Kreyl/IR_PCB/Testing.txt

1) Quartz
2) Flash
3) Lumos

4) Audio
5) Neopix
6) IR TX/RX
7) Side LEDs
8) Front LEDs
9) GPIO
10) Buzzer

FULL FW

11) USB + power
