Kreyl/IR_PCB/IR_PCB_hw/Factory/PCBdescription.txt

Описание PCB

Количество проводящих слоёв: 4
Материал: стандартный FR4
Толщина платы: 1мм (это важно!)
Толщина фольги: 18 или 35 мкм (0.5 или 1 oz)
Электроконтроль: да
Переходные отверстия: закрыты маской
Маска: обычная зелёная
Маркировка: обычная белая, с двух сторон
Покрытие площадок: ПОС-63 (или на усмотрение производства)
Мультипликация: на усмотрение производства
