Kreyl/IR_PCB/IRPCB_func.png

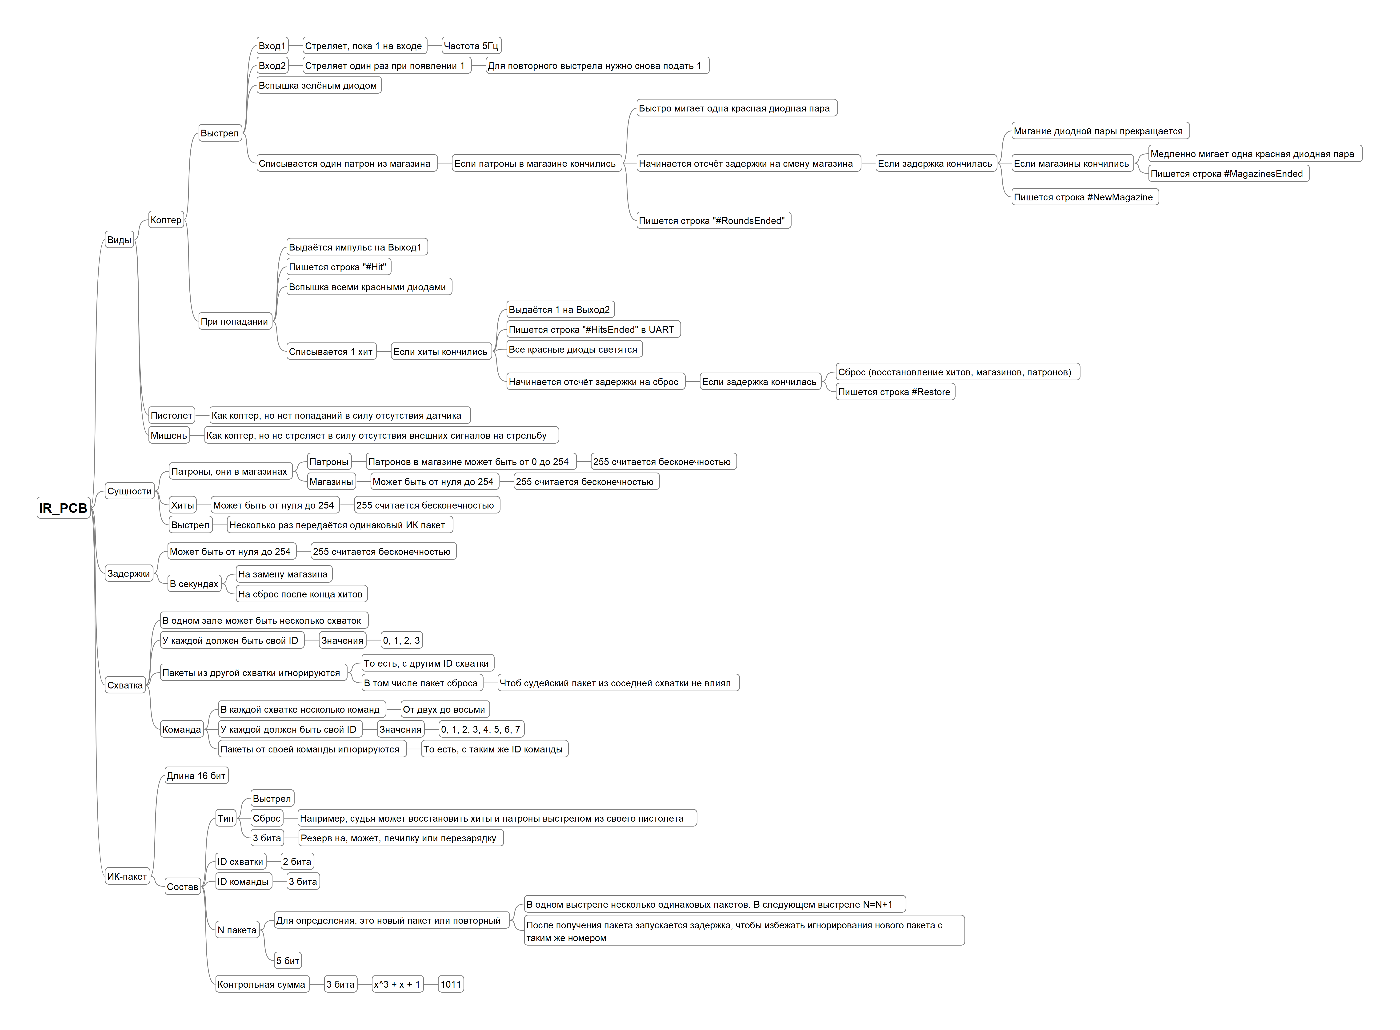
IRPCB_func.png
