Kreyl/IR_PCB/photo_2023-10-08_16-12-42.jpg

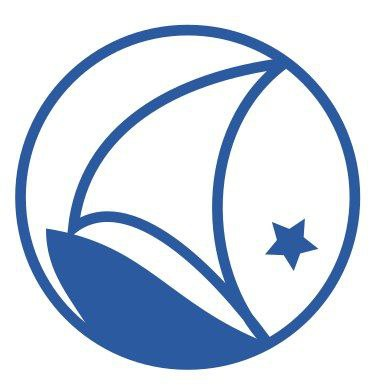
photo_2023-10-08_16-12-42.jpg
