Kreyl/IR_PCB/IR_PCB_hw/Factory/BOM_factory_04-02-2024.xlsx

Designator | Type | Value | PN | Footprint | Voltage | Description | Quantity | URL | Comment
BZ1 |  | 9650-5.5R/16R |  | Installation:BUZZER_HC0903 |  | Passive beeper | 1 | URL (https://aliexpress.ru/item/1005005350539003.html?sku_id=12000032711033322) | DoNotMount
C1 |  | 330uF |  | Capacitors:CAP_D | 6v3 | Cap Tant Solid 330uF 6.3V D CASE | 1 | URL (https://aliexpress.ru/item/32969159998.html?sku_id=66590165930)
C2, C5, C7, C9, C11, C12, C13, C15, C17, C19, C21, C23 | Capacitor SMD | 0.1u | CC0603KRX7R9BB104 | Capacitors:CAP_0603_Silks | 50V | X5R or X7R capacitor, 6.3V or higher | 12 | URL (https://www.promelec.ru/product/126354/)
C3 | Capacitor SMD | 2u2 | CL10A225KO8NNNC | Capacitors:CAP_0603_Silks | 16V | X5R or X7R capacitor, 6.3V or higher | 1 | URL (https://www.promelec.ru/product/316243/)
C4, C14 | Capacitor SMD | 18pF | CC0603JRNPO9BN180 | Capacitors:CAP_0603_Silks | 50V | NP0 capacitor, 6.3V or higher | 2 | URL (https://www.promelec.ru/product/128216/)
C6, C8 | Capacitor SMD | 1u | CL10A105KO8NNNC | Capacitors:CAP_0603_Silks | 16V | X5R or X7R capacitor, 6.3V or higher | 2 | URL (https://www.promelec.ru/product/335757/)
C10, C22, C24, C25 | Capacitor SMD | 10u | CL10A106MQ8NNNC | Capacitors:CAP_0603_Silks | 6V3 | X5R or X7R capacitor, 6.3V or higher | 4 | URL (https://www.promelec.ru/product/334535/)
C16, C18, C20 | Capacitor SMD | 47u | CL31A476MQHNNNE | Capacitors:CAP_1206 | 6v3 | X5R or X7R capacitor, 6.3V or higher | 3 | URL (https://www.promelec.ru/product/336530/)
D1 |  | TSAL6200 |  | LEDs:LED5mmR |  |  | 1 | URL (https://onelec.ru/products/tsal6200-1a020efd-62ab-4a3f-93a5-1ff21f61d27a) | DoNotMount
D2 |  | LTST-C191KGKT | LTST-C191KGKT | LEDs:LED_0603 |  |  | 1 | URL (https://www.promelec.ru/product/343092/)
D3, D4, D5, D6, D7, D8, D10, D11, D12, D13 |  | ~ |  | LEDs:LED5mmR |  |  | 10 | URL (https://aliexpress.ru/item/1005003323749658.html?sku_id=12000025211374467) | DoNotMount
D9 |  | PMEG2020 | PMEG2020AEA,115 | Diodes:SOD323 |  |  | 1 | URL (https://onelec.ru/products/pmeg2020aea-115-cdb00143-854a-4849-8e00-88d42820eb88)
DA1 |  | 74VHC1GT125 | M74VHC1GT125DT1G | SOT:SOT23-5 |  |  | 1 | URL (https://onelec.ru/products/m74vhc1gt125dt1g-fbb783f3-f3a3-454e-8678-86bfa439b8d1)
DA2 |  | LM1117GS-3.3 |  | SOT:SOT223 |  |  | 1 | URL (https://www.promelec.ru/product/479044/)
DD1 |  | GD32E103CB |  | LQFP_TQFP:LQFP48 |  |  | 1 | URL (https://www.promelec.ru/product/426829/)
DD2 |  | W25Q32JVSIQ | W25Q32JVSSIQ | SO_DIL_TSSOP:SO8_208MIL |  |  | 1 | URL (https://www.promelec.ru/product/507481/)
DD3 |  | MAX98357A | MAX98357AETE+T | QFN_DFN:QFN-16_EP_3x3_Pitch0.5mm |  |  | 1 | URL (https://aliexpress.ru/item/1005005819681447.html?sku_id=12000034463816107)
L1 | Inductor SMD | BLM15AG102 | BLM15AG102SN1D | Inductors:IND_0402_Fab |  | - | 1 | URL (https://www.promelec.ru/product/184235/)
Q1, Q2 |  | M28S |  | SOT:SOT23-3 |  |  | 2 | URL (https://www.chipdip.ru/product/m28s)
Q3, Q4, Q6 |  | TSOP4856 |  | Sensors:TSOP48xx |  |  | 3 | URL (https://onelec.ru/products/tsop4856-c5e4357e-a7a0-42b9-8627-1b51aed47544) | DoNotMount
Q5, Q7, Q8, Q9, Q10, Q11 |  | SI2301 |  | SOT:SOT23-3 |  | P-Chnl, 30v, 1.7A, 330mR@4.5v, Ciss=155pF | 6 | URL (https://www.chipdip.ru/product/si2301a)
R1, R12, R16, R17, R19, R22, R23, R24 | Resistor | 10k | RC0603FR-0710KL | Resistors:RES_0603_Silks |  | 1% resistor | 8 | URL (https://www.promelec.ru/product/108599/)
R2, R3, R4, R8 | Resistor | 1k | RC0603FR-071KL | Resistors:RES_0603_Silks |  | 1% resistor | 4 | URL (https://www.promelec.ru/product/22771/)
R5 | Resistor | 2R0 | RC0603FR-072RL | Resistors:RES_0603_Silks |  | 1% resistor | 1 | URL (https://www.promelec.ru/product/59444/)
R6, R7, R11, R13, R15, R18, R20, R21, R25, R26 | Resistor | 100R | RC0603FR-07100RL | Resistors:RES_0603_Silks |  | 1% resistor | 10 | URL (https://www.promelec.ru/product/57782/)
R9, R10, R14 | Resistor | 51R | RC0603FR-0751RL | Resistors:RES_0603_Silks |  | 1% resistor | 3 | URL (https://www.promelec.ru/product/18324/)
XL4 |  | DS1105-11 | DS1105-11-05SS8BNRS | Connectors:USBmicro_Connfly_DS1105-11 |  |  | 1 | URL (https://onelec.ru/products/ds1105-11-05ss8bnrs)
XTAL1 |  | 12MHz | SJK-7U-12.000-12-30-80-C-50 | Quartz:03225C4 |  |  | 1 | URL (https://www.promelec.ru/product/536327/)
