Kreyl/IR_PCB/IR_PCB_fwGD32/yartos/HowTo.txt

=== Static Thread creation example ===
Thread function:
static THD_WORKSPACE(waSecondThd, 256);
__attribute__((noreturn)) static void SecondThd() {
    while(true) {
        Sys::SleepMilliseconds(999);
    }
}

Initialization:
Sys::CreateThd(waSecondThd, sizeof(waSecondThd), NORMALPRIO, SecondThd);

==== How to wake sleeping thread from IRQ ====
Sys::Lock();
PMsdThd = Sys::GetSelfThd(); 
Sys::SleepS(TIME_INFINITE); // Wait forever until data is transmitted
Sys::Unlock();

void OnMSDDataIn() {
    if(PMsdThd and PMsdThd->state == ThdState::Sleeping) Sys::WakeI(&PMsdThd, retv::New);
}

==== Virtual Timer example ====
void VTimCallback(void *p) {
   ... 
}

VirtualTimer_t vt; 
uint32_t MyParam;

Starting:
vt.Set(TIME_MS2I(99), VTimCallback, (void*)MyParam);

==== PWM output ====
#define LED_R_PIN { GPIOB, 1, TIM3, 4, invInverted, omPushPull, 255 }
PinOutputPWM_t Led {LedPin};
