Kreyl/IR_PCB/IR_PCB_hw/Factory/IR_PCB.pdf

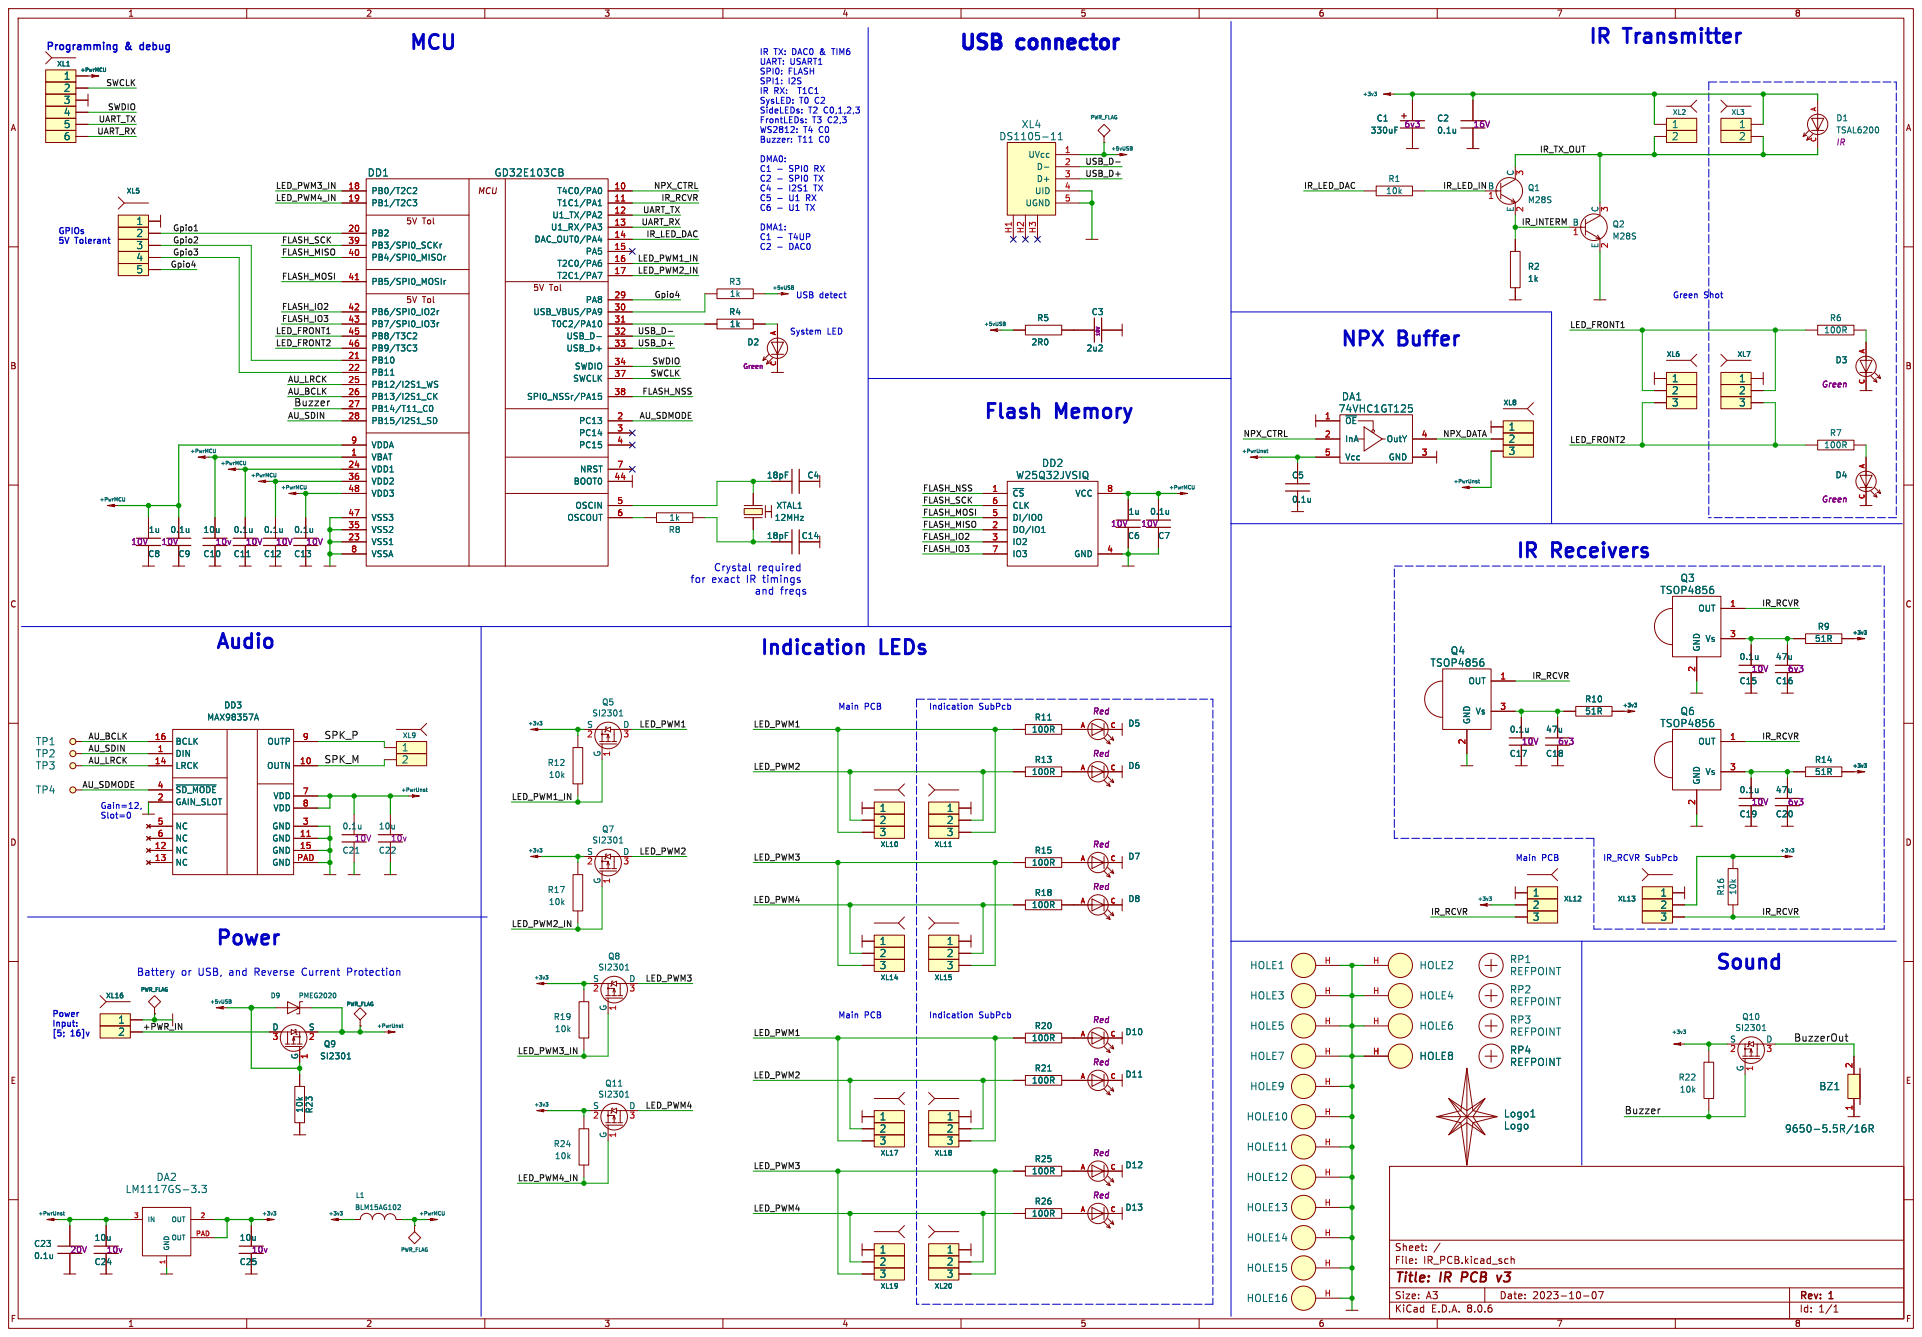
[picture p3: page 1]

IR TX: DAC0 & TIM6 UART: USART1 SPI0: FLASH

Id: 1/1 Title: IR PCB v3
