Kreyl/IR_PCB/IR_PCB_hw/Factory/AsmTop.pdf

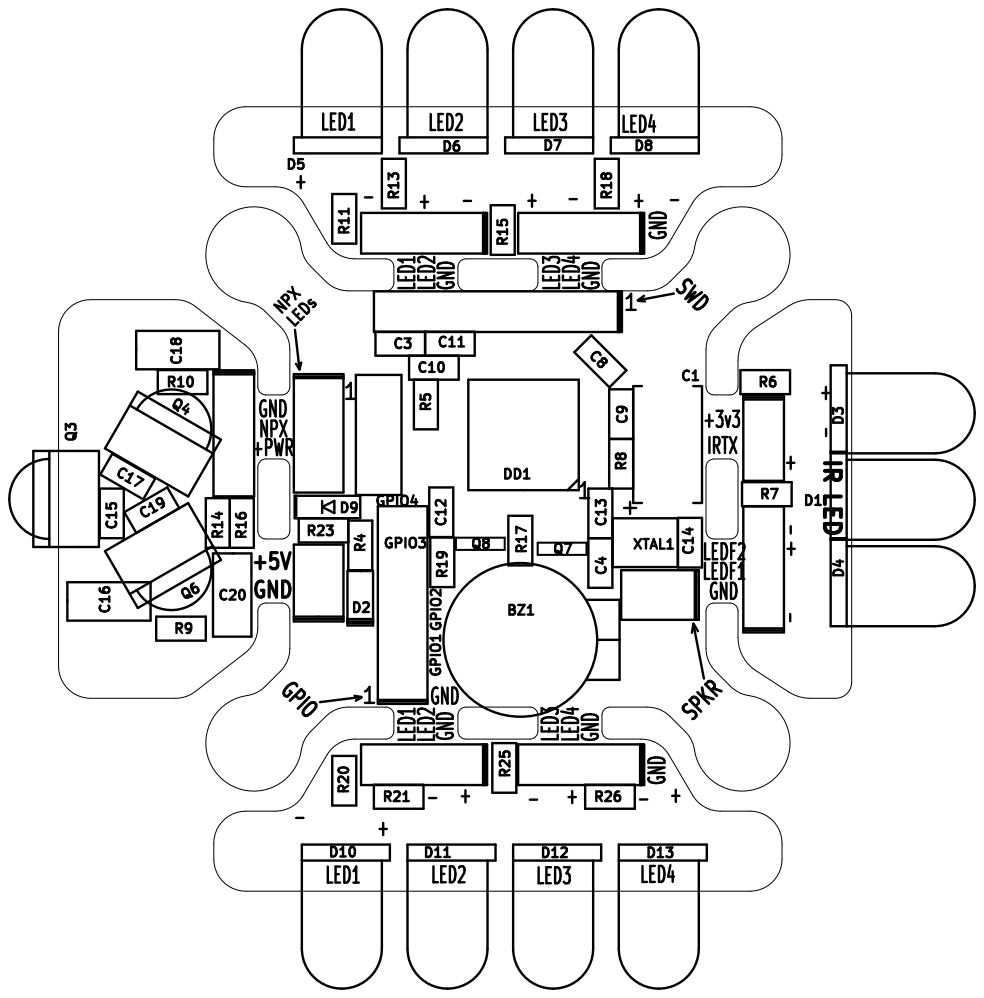
[picture p4: page 1]

- IR LED GND GPIO1 GND
