Kreyl/IR_PCB/IR_PCB_hw/IR_PCB.kicad_pcb

## KiCad design IR_PCB_hw/IR_PCB.kicad_pcb (2024-02-04)

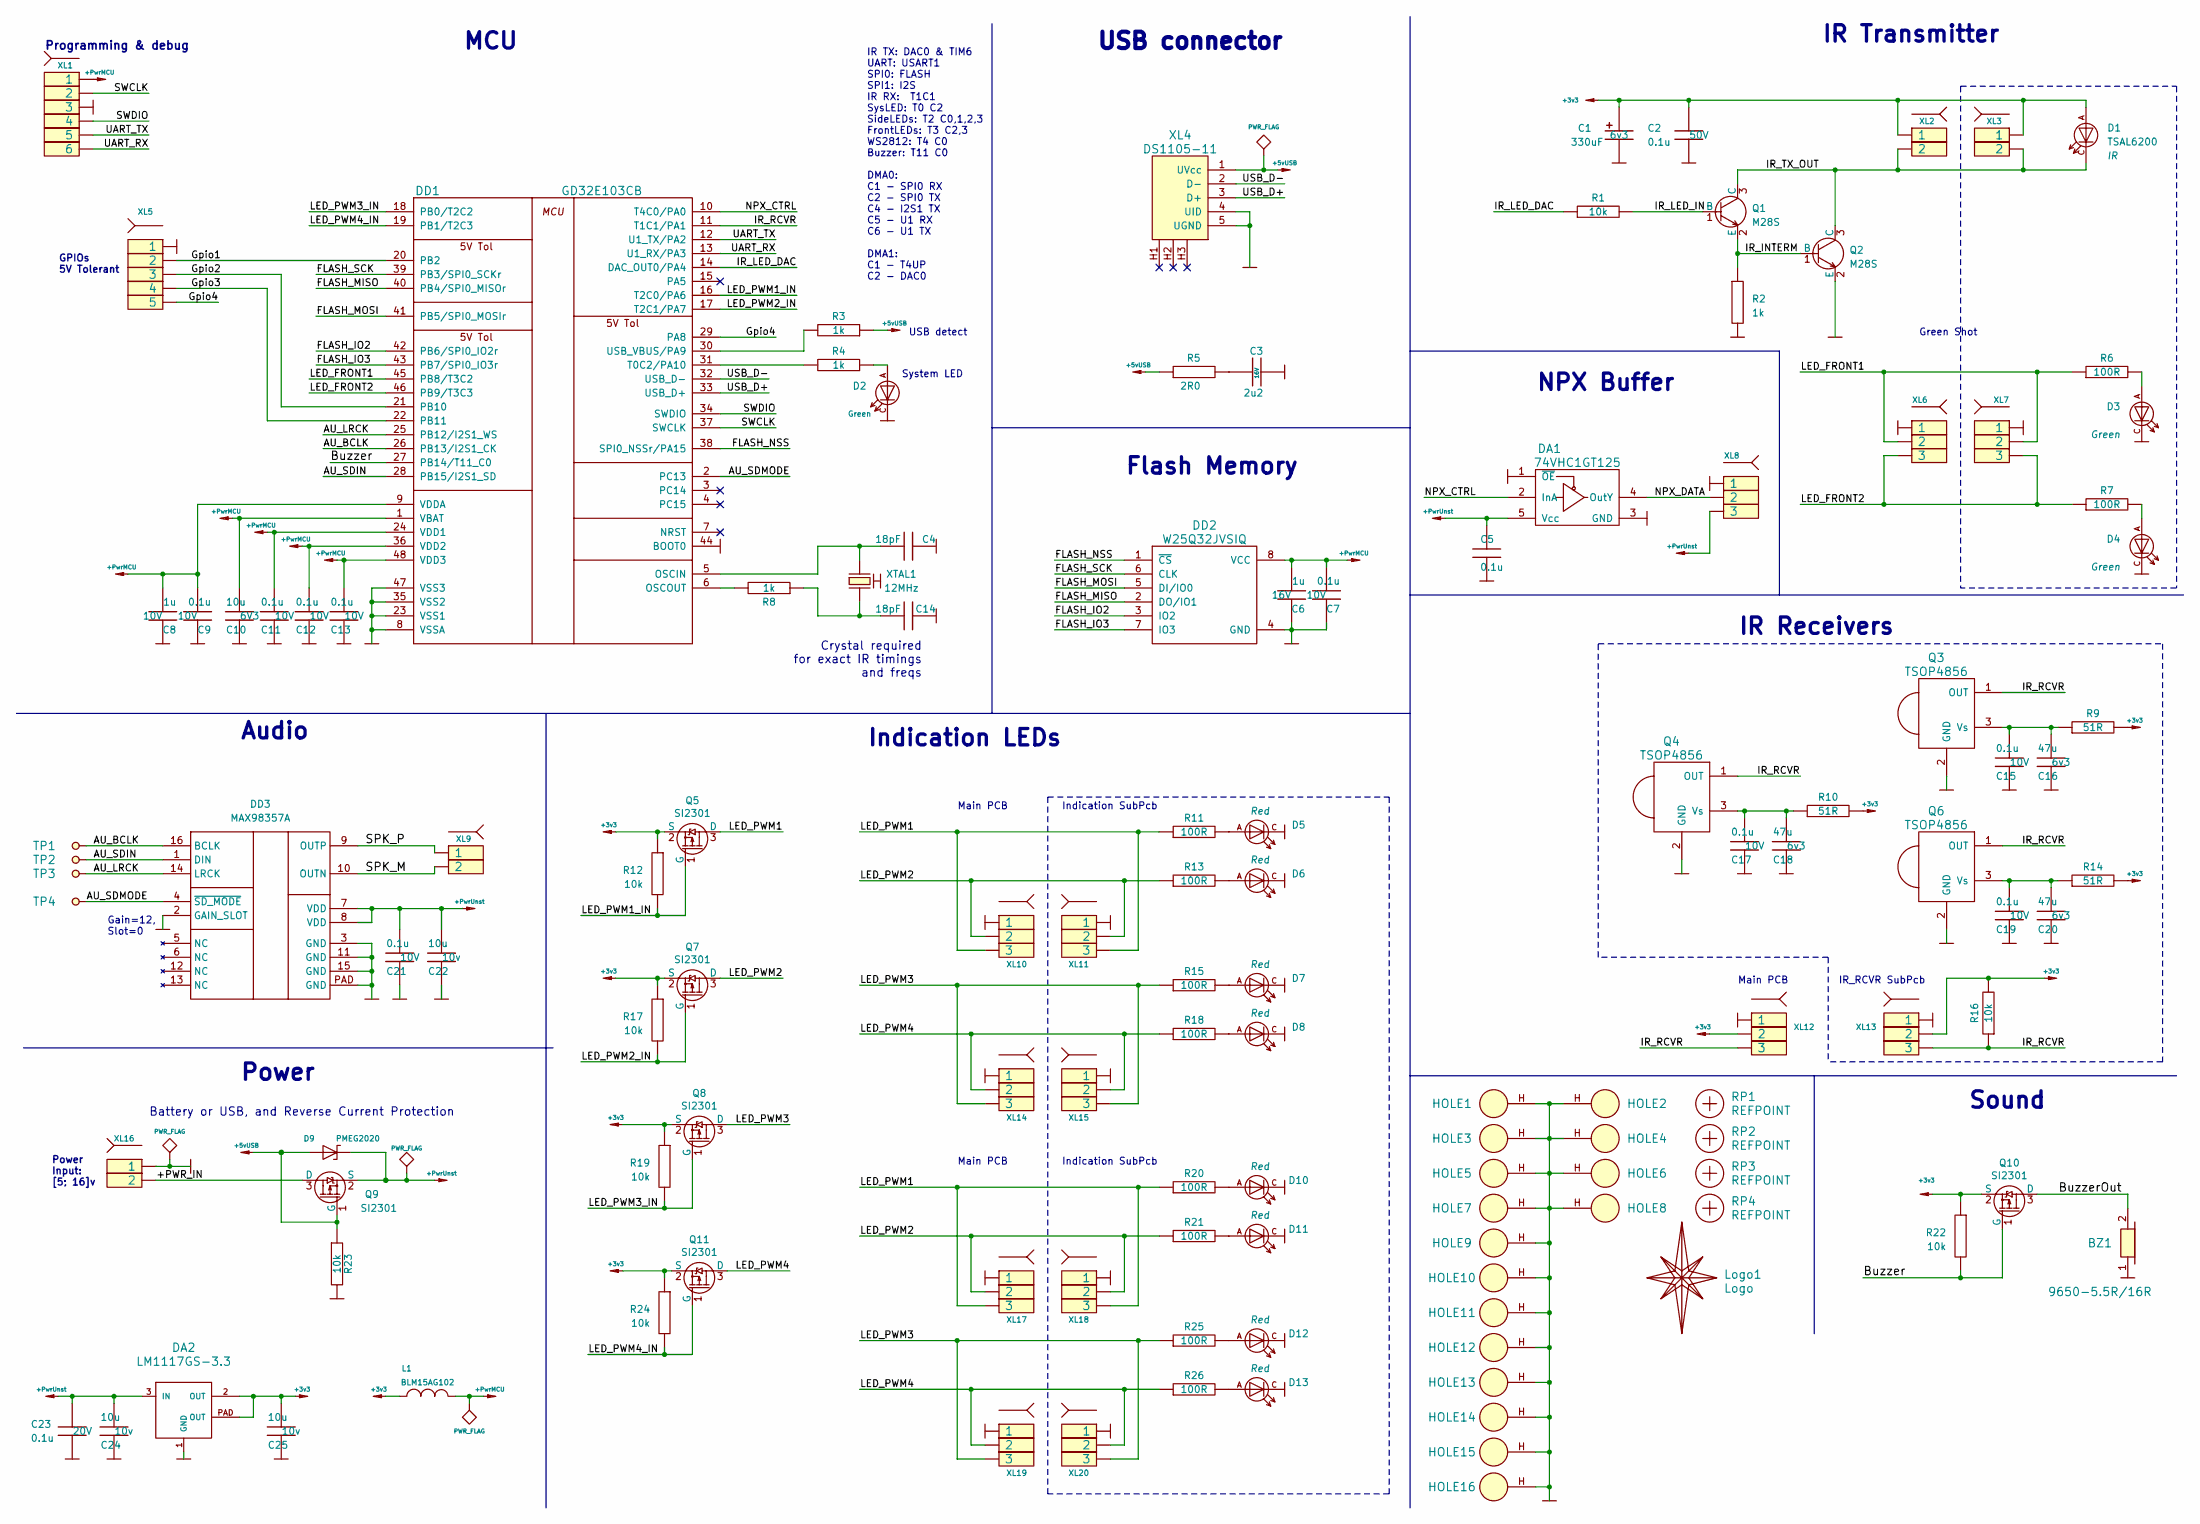
[picture p6: schematic IR_PCB.kicad_sch, IR PCB v3]

Parts:
BZ1: 9650-5.5R/16R; BUZZER_HC0903
C1: 330uF; CAP_D; Voltage 6v3
C2: 0.1u; CAP_0603_Silks; Tolerance 10%; Voltage 50V
C3: 2u2; CAP_0603_Silks; Tolerance 10%; Voltage 16V
C4, C14: 18pF; CAP_0603_Silks; Tolerance 5%; Voltage 50V
C5, C7, C9, C11, C12, C13, C15, C17, C19, C21: 0.1u; CAP_0603_Silks; Tolerance 20%; Voltage 10V
C6: 1u; CAP_0603_Silks; Tolerance 10%; Voltage 16V
C8: 1u; CAP_0603_Silks; Tolerance 10%; Voltage 10V
C10: 10u; CAP_0603_Silks; Tolerance 20%; Voltage 6V3
C16, C18, C20: 47u; CAP_1206; Tolerance 20%; Voltage 6v3
C22, C24, C25: 10u; CAP_0603_Silks; Tolerance 20%; Voltage 10v
C23: 0.1u; CAP_0603_Silks; Tolerance 20%; Voltage 20V
D1: TSAL6200; LED5mmR
D2: LTST-C191KGKT; LED_0603
D3, D4, D5, D6, D7, D8, D10, D11, D12, D13: LED5mmR
D9: PMEG2020; SOD323
DA1: 74VHC1GT125; SOT23-5
DA2: LM1117GS-3.3; SOT223
DD1: GD32E103CB; LQFP48
DD2: W25Q32JVSIQ; SO8_208MIL
DD3: MAX98357A; QFN-16_EP_3x3_Pitch0.5mm
HOLE1, HOLE2, HOLE3, HOLE4, HOLE5, HOLE6, HOLE7, HOLE8, HOLE9, HOLE10, HOLE11, HOLE12: HOLE_METALLED; Hole2d7_out4d2mm
HOLE13, HOLE14, HOLE15, HOLE16: HOLE_METALLED; Hole4_out5d3mm
L1: BLM15AG102; IND_0402_Fab; Tolerance 20%
Logo1: Logo; KiberiadaTYUKF
Q1, Q2: M28S; SOT23-3
Q3, Q4, Q6: TSOP4856; TSOP48xx
Q5, Q7, Q8, Q9, Q10, Q11: SI2301; SOT23-3
R1, R12, R16, R17, R19, R22, R23, R24: 10k; RES_0603_Silks; Tolerance 1%
R2, R3, R4, R8: 1k; RES_0603_Silks; Tolerance 1%
R5: 2R0; RES_0603_Silks; Tolerance 1%
R6, R7, R11, R13, R15, R18, R20, R21, R25, R26: 100R; RES_0603_Silks; Tolerance 1%
R9, R10, R14: 51R; RES_0603_Silks; Tolerance 1%
RP1, RP2, RP3, RP4: REFPOINT; REF_POINT_1MM
TP1, TP2, TP3, TP4: TESTPOINT; TESTPOINT_1MM
XL1: SOCKET_6; PLS-6-NoHole
XL2, XL9: SOCKET_2; SLD_2_2D5_SMD
XL3: SOCKET_2; PLS-2
XL4: DS1105-11; USBmicro_Connfly_DS1105-11
XL5: SOCKET_5; SLD_5_2D5_SMD
XL6, XL8, XL10, XL12, XL14, XL17, XL19: SOCKET_3; SLD_3_2D5_SMD
XL7, XL11, XL13, XL15, XL18, XL20: SOCKET_3; PLS-3
XL16: SOCKET_2; SLD_2_2D5
XTAL1: 12MHz; 03225C4

Connections:
+3v3: C1.1, C2.1, C25.1, D1.A, DA2.2 (OUT), DA2.PAD (OUT), L1.2, Q5.2 (S), Q7.2 (S), Q8.2 (S), Q10.2 (S), Q11.2 (S), R9.2, R10.2, R12.1, R14.2, R16.2, R17.1, R19.1, R22.1, R24.1, XL2.1, XL3.1, XL12.2, XL13.2
+5vUSB: D9.A, Q9.1 (G), R3.1, R5.1, R23.1, XL4.1 (UVcc)
+PwrMCU: C6.1, C7.1, C8.1, C9.1, C10.1, C11.1, C12.1, C13.1, DD1.1 (VBAT), DD1.9 (VDDA), DD1.24 (VDD1), DD1.36 (VDD2), DD1.48 (VDD3), DD2.8 (VCC), L1.1, XL1.1
+PwrUnst: C5.1, C21.1, C22.1, C23.1, C24.1, D9.C, DA1.5 (Vcc), DA2.3 (IN), DD3.7 (VDD), DD3.8 (VDD), Q9.2 (S), XL8.3
/+PWR_IN: Q9.3 (D), XL16.2
/AU_BCLK: DD1.26 (PB13/I2S1_CK), DD3.16 (BCLK), TP1.1
/AU_LRCK: DD1.25 (PB12/I2S1_WS), DD3.14 (LRCK), TP3.1
/AU_SDIN: DD1.28 (PB15/I2S1_SD), DD3.1 (DIN), TP2.1
/AU_SDMODE: DD1.2 (PC13), DD3.4 (~SD_MODE), TP4.1
/Buzzer: DD1.27 (PB14/T11_C0), Q10.1 (G), R22.2
/BuzzerOut: BZ1.2, Q10.3 (D)
/FLASH_IO2: DD1.42 (PB6/SPI0_IO2r), DD2.3 (IO2)
/FLASH_IO3: DD1.43 (PB7/SPI0_IO3r), DD2.7 (IO3)
/FLASH_MISO: DD1.40 (PB4/SPI0_MISOr), DD2.2 (DO/IO1)
/FLASH_MOSI: DD1.41 (PB5/SPI0_MOSIr), DD2.5 (DI/IO0)
/FLASH_NSS: DD1.38 (SPI0_NSSr/PA15), DD2.1 (~CS)
/FLASH_SCK: DD1.39 (PB3/SPI0_SCKr), DD2.6 (CLK)
/Gpio1: DD1.20 (PB2), XL5.2
/Gpio2: DD1.21 (PB10), XL5.3
/Gpio3: DD1.22 (PB11), XL5.4
/Gpio4: DD1.29 (PA8), XL5.5
/IR_INTERM: Q1.2 (E), Q2.1 (B), R2.1
/IR_LED_DAC: DD1.14 (DAC_OUT0/PA4), R1.1
/IR_LED_IN: Q1.1 (B), R1.2
/IR_RCVR: DD1.11 (T1C1/PA1), Q3.1 (OUT), Q4.1 (OUT), Q6.1 (OUT), R16.1, XL12.3, XL13.3
/IR_TX_OUT: D1.C, Q1.3 (C), Q2.3 (C), XL2.2, XL3.2
/LED_FRONT1: DD1.45 (PB8/T3C2), R6.1, XL6.2, XL7.2
/LED_FRONT2: DD1.46 (PB9/T3C3), R7.1, XL6.3, XL7.3
/LED_PWM1: Q5.3 (D), R11.1, R20.1, XL10.3, XL11.3, XL17.3, XL18.3
/LED_PWM1_IN: DD1.16 (T2C0/PA6), Q5.1 (G), R12.2
/LED_PWM2: Q7.3 (D), R13.1, R21.1, XL10.2, XL11.2, XL17.2, XL18.2
/LED_PWM2_IN: DD1.17 (T2C1/PA7), Q7.1 (G), R17.2
/LED_PWM3: Q8.3 (D), R15.1, R25.1, XL14.3, XL15.3, XL19.3, XL20.3
/LED_PWM3_IN: DD1.18 (PB0/T2C2), Q8.1 (G), R19.2
/LED_PWM4: Q11.3 (D), R18.1, R26.1, XL14.2, XL15.2, XL19.2, XL20.2
/LED_PWM4_IN: DD1.19 (PB1/T2C3), Q11.1 (G), R24.2
/NPX_CTRL: DA1.2 (InA), DD1.10 (T4C0/PA0)
/NPX_DATA: DA1.4 (OutY), XL8.2
/SPK_M: DD3.10 (OUTN), XL9.2
/SPK_P: DD3.9 (OUTP), XL9.1
/SWCLK: DD1.37 (SWCLK), XL1.2
/SWDIO: DD1.34 (SWDIO), XL1.4
/UART_RX: DD1.13 (U1_RX/PA3), XL1.6
/UART_TX: DD1.12 (U1_TX/PA2), XL1.5
/USB_D+: DD1.33 (USB_D+), XL4.3 (D+)
/USB_D-: DD1.32 (USB_D-), XL4.2 (D-)
unnamed: C3.1, R5.2
unnamed: C14.1, R8.1, XTAL1.2
unnamed: D2.A, R4.1
unnamed: D3.A, R6.2
unnamed: D4.A, R7.2
unnamed: D5.A, R11.2
unnamed: D6.A, R13.2
unnamed: D7.A, R15.2
unnamed: D8.A, R18.2
unnamed: D10.A, R20.2
unnamed: D11.A, R21.2
unnamed: D12.A, R25.2
unnamed: D13.A, R26.2
unnamed: C4.1, DD1.5 (OSCIN), XTAL1.1
unnamed: DD1.6 (OSCOUT), R8.2
unnamed: DD1.30 (USB_VBUS/PA9), R3.2
unnamed: DD1.31 (T0C2/PA10), R4.2
unnamed: C15.1, C16.1, Q3.3 (Vs), R9.1
unnamed: C17.1, C18.1, Q4.3 (Vs), R10.1
unnamed: C19.1, C20.1, Q6.3 (Vs), R14.1

Notes on the sheet:
Main PCB
Power Input: [5; 16]v
IR TX: DAC0 & TIM6 UART: USART1 SPI0: FLASH SPI1: I2S IR RX: T1C1 SysLED: T0 C2 SideLEDs: T2 C0,1,2,3 FrontLEDs: T3 C2,3 WS2812: T4 C0 Buzzer: T11 C0 DMA0: C1 - SPI0 RX C2 - SPI0 TX C4 - I2S1 TX C5 - U1 RX C6 - U1 TX DMA1: C1 - T4UP C2 - DAC0
IR_RCVR SubPcb
Power
Indication SubPcb
MCU
USB detect
Gain=12, Slot=0
NPX Buffer
System LED
Flash Memory
Battery or USB, and Reverse Current Protection
Crystal required for exact IR timings and freqs
Audio
Sound
Green Shot
USB connector
IR Transmitter
Programming & debug
IR Receivers
GPIOs 5V Tolerant
Indication LEDs

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
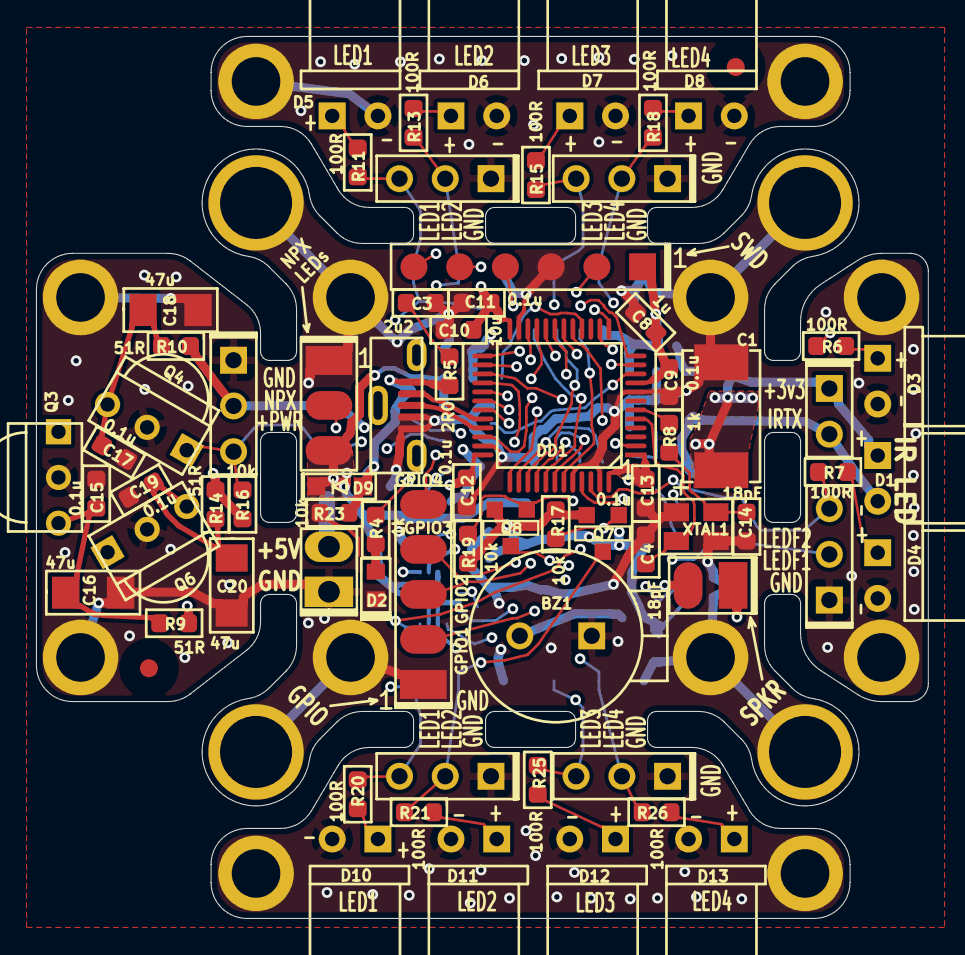
[picture p7: board IR_PCB.kicad_pcb from above]

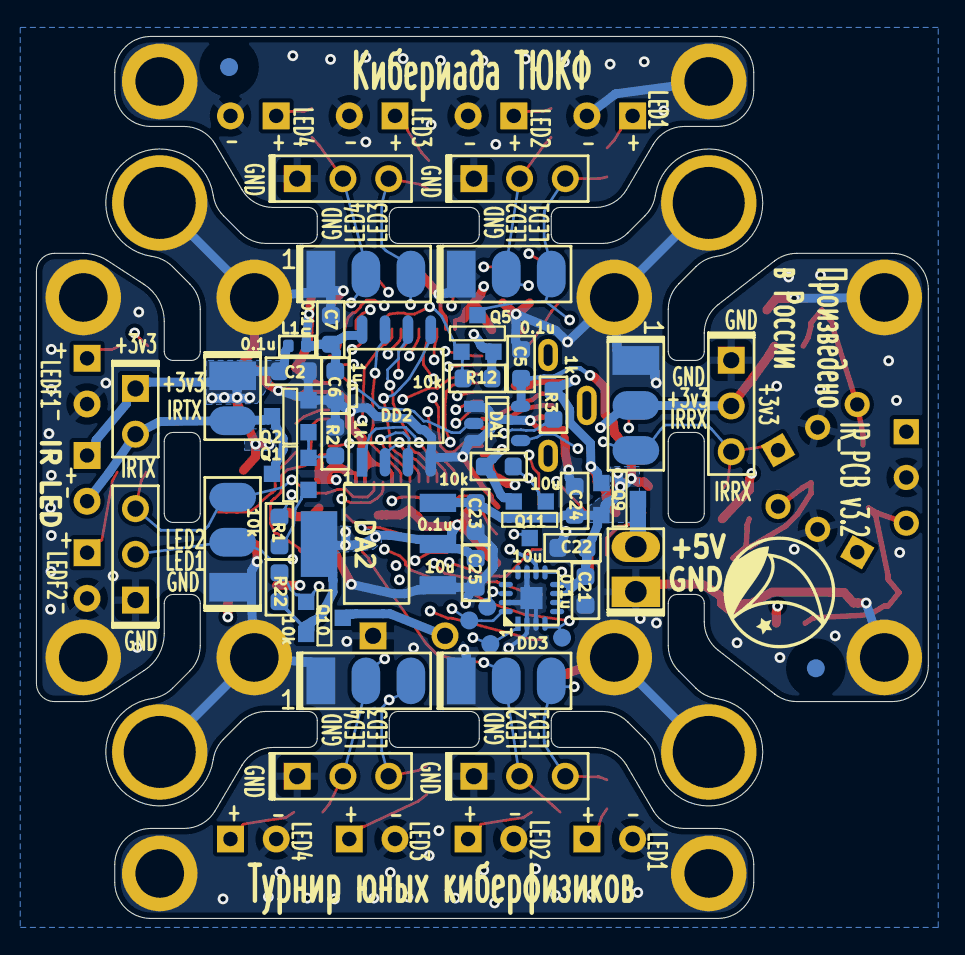
[picture p8: board IR_PCB.kicad_pcb from below]

Board: 4 copper layers, 49.5 x 49.0 mm, 128 parts (40 on the bottom side), 67 nets.
