Kreyl/IR_PCB/IR_PCB_fwGD32/Filesys/ccsbcs.c

/*------------------------------------------------------------------------*/
/* Unicode - Local code bidirectional converter  (C)ChaN, 2009            */
/* (SBCS code pages)                                                      */
/*------------------------------------------------------------------------*/
/*  437   U.S. (OEM)
/   720   Arabic (OEM)
/   1256  Arabic (Windows)
/   737   Greek (OEM)
/   1253  Greek (Windows)
/   1250  Central Europe (Windows)
/   775   Baltic (OEM)
/   1257  Baltic (Windows)
/   850   Multilingual Latin 1 (OEM)
/   852   Latin 2 (OEM)
/   1252  Latin 1 (Windows)
/   855   Cyrillic (OEM)
/   1251  Cyrillic (Windows)
/   866   Russian (OEM)
/   857   Turkish (OEM)
/   1254  Turkish (Windows)
/   858   Multilingual Latin 1 + Euro (OEM)
/   862   Hebrew (OEM)
/   1255  Hebrew (Windows)
/   874   Thai (OEM, Windows)
/   1258  Vietnam (OEM, Windows)
*/

#include "ff.h"


#if _CODE_PAGE == 437
#define _TBLDEF 1
static
const WCHAR Tbl[] = {	/*  CP437(0x80-0xFF) to Unicode conversion table */
	0x00C7, 0x00FC, 0x00E9, 0x00E2, 0x00E4, 0x00E0, 0x00E5, 0x00E7,
	0x00EA, 0x00EB, 0x00E8, 0x00EF, 0x00EE, 0x00EC, 0x00C4, 0x00C5,
	0x00C9, 0x00E6, 0x00C6, 0x00F4, 0x00F6, 0x00F2, 0x00FB, 0x00F9,
	0x00FF, 0x00D6, 0x00DC, 0x00A2, 0x00A3, 0x00A5, 0x20A7, 0x0192,
	0x00E1, 0x00ED, 0x00F3, 0x00FA, 0x00F1, 0x00D1, 0x00AA, 0x00BA,
	0x00BF, 0x2310, 0x00AC, 0x00BD, 0x00BC, 0x00A1, 0x00AB, 0x00BB,
	0x2591, 0x2592, 0x2593, 0x2502, 0x2524, 0x2561, 0x2562, 0x2556,
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
	int i;


	for (i = 0; tbl_lower[i] && chr != tbl_lower[i]; i++) ;

	return tbl_lower[i] ? tbl_upper[i] : chr;
}
