Kreyl/IR_PCB/IR_PCB_fwGD32/Filesys/fatfs_syscall.c

/*
    ChibiOS/RT - Copyright (C) 2006,2007,2008,2009,2010,
                 2011 Giovanni Di Sirio.

    This file is part of ChibiOS/RT.

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
    You should have received a copy of the GNU General Public License
    along with this program.  If not, see <http://www.gnu.org/licenses/>.
*/

/*------------------------------------------------------------------------*/
/* Sample code of OS dependent controls for FatFs R0.08b                  */
/* (C)ChaN, 2011                                                          */
/*------------------------------------------------------------------------*/

#include "ff.h"

#if _FS_REENTRANT
/*------------------------------------------------------------------------*/
/* Static array of Synchronization Objects                                */
/*------------------------------------------------------------------------*/
static semaphore_t ff_sem[_VOLUMES];

/*------------------------------------------------------------------------*/
/* Create a Synchronization Object                                        */
/*------------------------------------------------------------------------*/
int ff_cre_syncobj(BYTE vol, _SYNC_t *sobj) {

  *sobj = &ff_sem[vol];
  chSemObjectInit(*sobj, 1);
  return TRUE;
}

/*------------------------------------------------------------------------*/
/* Delete a Synchronization Object                                        */
/*------------------------------------------------------------------------*/
int ff_del_syncobj(_SYNC_t sobj) {

  chSemReset(sobj, 0);
  return TRUE;
}

/*------------------------------------------------------------------------*/
/* Request Grant to Access the Volume                                     */
/*------------------------------------------------------------------------*/
int ff_req_grant(_SYNC_t sobj) {

  msg_t msg = chSemWaitTimeout(sobj, (systime_t)_FS_TIMEOUT);
  return msg == MSG_OK;
}

/*------------------------------------------------------------------------*/
/* Release Grant to Access the Volume                                     */
/*------------------------------------------------------------------------*/
void ff_rel_grant(_SYNC_t sobj) {

  chSemSignal(sobj);
}
#endif /* _FS_REENTRANT */

#if _USE_LFN == 3	/* LFN with a working buffer on the heap */
/*------------------------------------------------------------------------*/
/* Allocate a memory block                                                */
/*------------------------------------------------------------------------*/
void *ff_memalloc(UINT size) {

  return chHeapAlloc(NULL, size);
}

/*------------------------------------------------------------------------*/
/* Free a memory block                                                    */
/*------------------------------------------------------------------------*/
void ff_memfree(void *mblock) {

  chHeapFree(mblock);
}
#endif /* _USE_LFN == 3 */
