Kreyl/IR_PCB/IR_PCB_fwGD32/Audio/max98357.h

/*
 * max98357.h
 *
 *  Created on: 18.09.2022
 *      Author: Kreyl
 */

#ifndef __MAX98357_H
#define __MAX98357_H

#include "gd_lib.h"

// Beware: PLL2 is used for I2S clk generation, use Crystal to feed PLL2, not IRC48M

struct StereoSample_t {
    int16_t left, right;
} __attribute__((packed));

namespace Codec {

extern ftVoidVoid cb_I2S_dma_doneI;
void Init();

// supports 8kHz, 16kHz, 32kHz, 44.1kHz, 48kHz, 88.2kHz and 96kHz only
retv SetupSampleRate(uint32_t Fs);
//    void Put(uint16_t Data) { AU_SAI_A->DR = Data; }

void TransmitBuf(void *buf, uint32_t sz16);
bool IsTransmitting();
void Stop();
};

#endif // __MAX98357_H
