Kreyl/IR_PCB/IR_PCB_fwGD32/usb/scsi.c

/*
 * scsi.c
 *
 *  Created on: Oct 9, 2013
 *      Author: g.kruglov
 */

#include "scsi.h"

const SCSI_InquiryResponse_t InquiryData = {
        Peripheral:         0x00,   // direct access block device, connected
        Removable:          0x80,   // device is removable
        Version:            0x04,   // SPC-2 compliance
        ResponseDataFormat: 0x02,
        AdditionalLength:   31,   // == 36-5
        Sccstp:             0x00,
        bqueetc:            0x00,
        CmdQue:             0x00,
        VendorID:           "WarSaber",
        ProductID:          "MassStorage     ",
        ProductRev:         "0002"
};

// USB Mass storage Page 0 Inquiry Data
const uint8_t Page00InquiryData[PAGE0_INQUIRY_DATA_SZ] = {
    0x00,
    0x00,
    0x00,
    (PAGE0_INQUIRY_DATA_SZ - 4),
    0x00,
    0x80,
    0x83
};

// USB Mass storage sense 6  Data
const uint8_t Mode_Sense6_data[MODE_SENSE6_DATA_SZ] = {
    0x00,
    0x00,
    0x00,
    0x00,
    0x00,
    0x00,
    0x00,
    0x00
};
