Kreyl/IR_PCB/IR_PCB_GD32Boot/usb/mem_msd_glue.cpp

/*
 * mem_msd_glue.cpp
 *
 *  Created on: 30 ���. 2016 �.
 *      Author: Kreyl
 */

#include "mem_msd_glue.h"
#include "shell.h"
#include "SpiFlash.h"

#include "diskio.h"

extern SpiFlash_t SpiFlash;

namespace MsdMem {

uint32_t BlockCnt, BlockSz;

retv Read(uint32_t BlockAddress, uint8_t *Ptr, uint32_t BlocksCnt) {
//    Printf("R %u %u\r", BlockAddress, BlocksCnt);
    retv r = SpiFlash.Read(BlockAddress * BlockSz, Ptr, BlocksCnt * BlockSz);
//    retv r = SpiFlash.ReadQ(BlockAddress * BlockSz, Ptr, BlocksCnt * BlockSz);
//    if(r == retv::Ok) Printf("%A\r", Ptr, BlocksCnt * BlockSz);
    return r;
}

retv Write(uint32_t BlockAddress, uint8_t *Ptr, uint32_t BlocksCnt) {
//    Printf("W %u %u\r", BlockAddress, BlocksCnt);
    uint32_t PageCnt = (BlocksCnt * BlockSz) / SPIFLASH_PAGE_SZ;
    // Erase sectors
    uint32_t Addr = BlockAddress * BlockSz;
    while(BlocksCnt) {
        if(SpiFlash.EraseSector4k(Addr) != retv::Ok) return retv::Fail;
        Addr += BlockSz;
        BlocksCnt--;
    }
    // Write data page by page
    Addr = BlockAddress * BlockSz;
    while(PageCnt) {
//        if(SpiFlash.WritePage(Addr, Ptr, SPIFLASH_PAGE_SZ) != retv::Ok) {
        if(SpiFlash.WritePageQ(Addr, Ptr, SPIFLASH_PAGE_SZ) != retv::Ok) return retv::Fail;
        Addr += SPIFLASH_PAGE_SZ;
        Ptr += SPIFLASH_PAGE_SZ;
        PageCnt--;
    }
    return retv::Ok;
}

} // namespace
