Kreyl/IR_PCB/(commit log)

2023-08-04 Sch started
    [IR_PCB.kicad_pcb, IR_PCB.kicad_sch]
2023-08-04 Sch in progress
    [IR_PCB.kicad_sch]
2023-08-05 Layout done
    [IR_PCB.kicad_pcb, IR_PCB.kicad_sch]
2023-08-05 Silks done
    [IR_PCB.kicad_pcb]
2023-08-05 Sent to factory
    [IR_PCB.kicad_pcb]
2023-08-05 + BOM
    [BOM_05-08-2023.xlsx, IR_PCB.kicad_sch]
2023-08-11 + FW UART works
2023-08-12 LEDs work
2023-08-14 State machines started
    [IR_PCB-B_Paste.dxf, IR_PCB-F_Paste.dxf, IR_PCB-F_PasteNoMcu.dxf, IR_PCB.kicad_pcb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]
2023-10-04 Layout started
    [IR_PCB.kicad_pcb, IR_PCB.kicad_sch]
2023-10-07 Layout in progress
    [IR_PCB.kicad_pcb, IR_PCB.kicad_sch]
2023-10-08 PCBv3 sent to factory
    [BOM_05-08-2023.xlsx, IR_PCB-B_Paste.dxf, IR_PCB-F_Paste.dxf, IR_PCB-F_PasteNoMcu.dxf, IR_PCB.kicad_pcb, IR_PCB.kicad_sch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]
2023-10-16 PCB v 3.1
    [IR_PCB.kicad_pcb, IR_PCB.kicad_sch]
2023-10-17 working on bom
    [IR_PCB.kicad_sch]
2023-10-18 BOM constructed
    [BOM_18-10-2023.xlsx, IR_PCB.kicad_sch]
2023-10-23 + Factory BOM
    [BOM_18102023_factory.xlsx]
2023-10-23 + PCB desc
2023-10-24 Replace USB conn with micro one Replace 0402 wit 0603
    [IR_PCB.kicad_pcb, IR_PCB.kicad_sch]
2023-10-25 RTOS, UART, XTAL work
    [IR_PCB.kicad_pcb]
2023-10-25 SPI in progress
2023-10-26 Flash in Quad mode works ok
    [BOM_18-10-2023.xlsx]
2023-10-28 ADC in progress
2023-10-28 ADC again
2023-10-30 Usb conn moved
    [IR_PCB.kicad_pcb]
2023-10-30 ADC is not working
2023-10-30 PCB v3.2 Routing done, cleanup done
    [IR_PCB.kicad_pcb]
2023-10-31 ADC works
2023-11-10 Switching to CDC+MSD
    [IR_PCB.kicad_pcb, IR_PCB.kicad_sch]
2023-11-16 Fix bug with timer init instead of alarm stop
    [SpiFlash.cpp]
2023-11-21 Bootloader seem ok
    [IR_PCB-B_Paste_5x2.dxf, IR_PCB-F_Paste_5x2.dxf]
2023-11-21 Bootloader resets everything before jumping
    [main.cpp]
2023-11-24 + Add App + Add settings + Add pin IRQ & EXTI
2023-11-24 * Allow damage from player with same ID, but other team
    [app.cpp, main.cpp]
2023-11-24 + Add reboot to bootloader
    [main.cpp]
2023-12-09 Reply to command to where it came from (USB in general), not debug UART
2023-12-10 * Fix USB CDC bug, which leads to failures during printing * Testing disables app * Refactor MSD SCSI
    [EvtMsgIDs.h, app.cpp, board.h, main.cpp, scsi.h]
2024-01-13 + IR TX frequency made parametric in settings + Help on commands available
    [DAC buf calc.xlsx]
2024-02-04 Preparation for factory
    [BOM_18-10-2023.xlsx, BOM_18102023_factory.xlsx, BOM_factory_04-02-2024.xlsx, IR_PCB-B_Paste_5x2.dxf, IR_PCB-F_Paste_5x2.dxf, IR_PCB.kicad_pcb, IR_PCB.kicad_sch]
2024-02-28 Fixed: values in form '0x8305' now read from settings.ini successfully
    [Settings.cpp, kl_fs_utils.cpp, kl_fs_utils.h, main.cpp]
2024-04-19 Spi Flash added to boot
2024-06-30 Huge refactoring + PWM input works
    [IR_PCB.kicad_sch]
2024-07-02 Working on зле rx
2024-07-04 + pkt printing
2024-09-02 working on pin mode select
2025-03-05 UART buf increased to 3000 chars
